milador/FAIO_Multiplexer_Wireless/Resources/Arduino_Upload.png

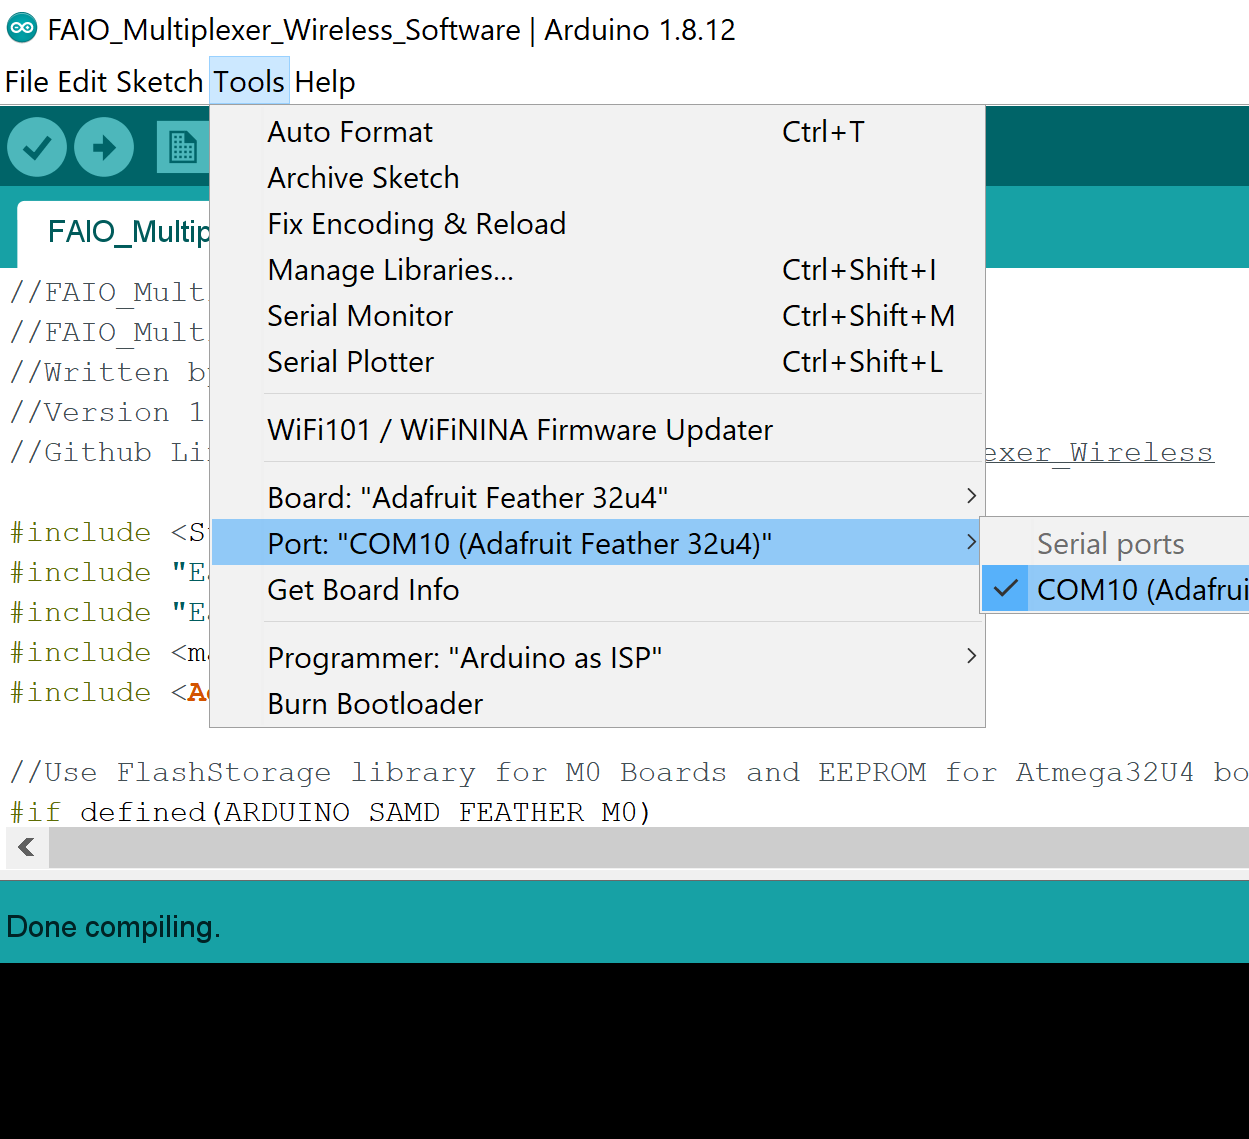
Resources/Arduino_Upload.png
