milador/FAIO_Multiplexer_Wireless/Hardware/Housing_design/STEP/FAIO_Multiplexer_Body_Battery_Holder.step

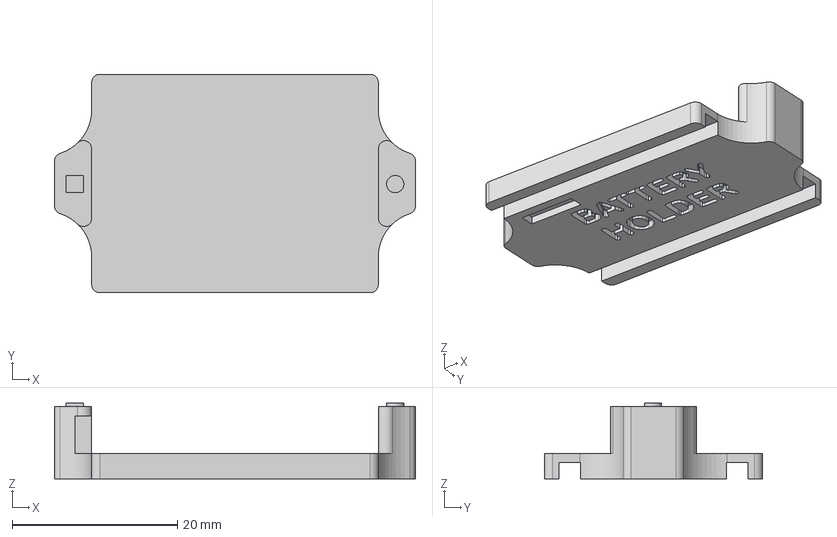
[picture p7: CAD file, 2021-01-18]
Hardware/Housing_design/STEP/FAIO_Multiplexer_Body_Battery_Holder.step
43.7 x 26.5 x 9.20 mm
