milador/FAIO_Multiplexer_Wireless/Hardware/Housing_design/STEP/FAIO_Multiplexer_Body_Bottom.step

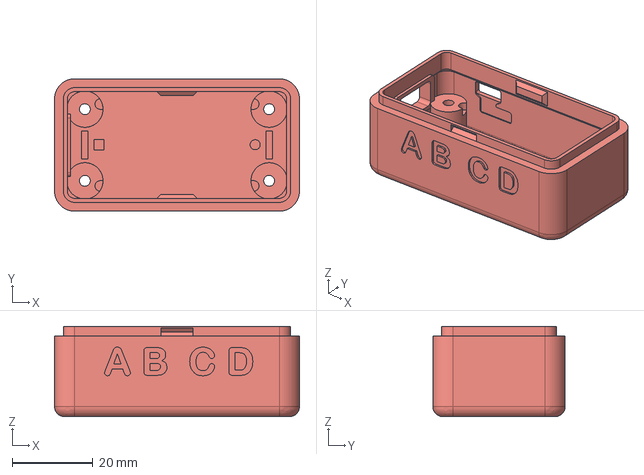
[picture p8: CAD file, 2021-01-18]
Hardware/Housing_design/STEP/FAIO_Multiplexer_Body_Bottom.step
60.8 x 32.9 x 22.4 mm
