milador/FAIO_Multiplexer_Wireless/Hardware/Housing_design/STEP/FAIO_Multiplexer_Body_Top.step

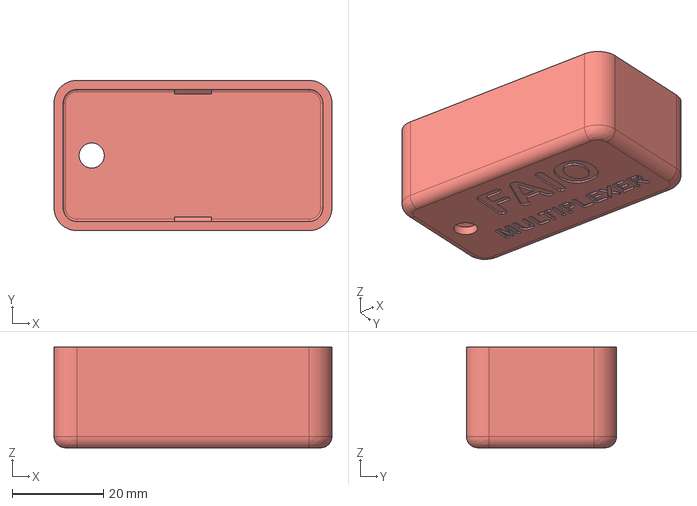
[picture p9: CAD file, 2021-01-18]
Hardware/Housing_design/STEP/FAIO_Multiplexer_Body_Top.step
60.8 x 32.9 x 22.0 mm
