milador/FAIO_Multiplexer_Wireless/(list of files, cad)

Other CAD files:
Hardware/Housing_design/STL/FAIO_Multiplexer_Body_Battery_Holder.stl
Hardware/Housing_design/STL/FAIO_Multiplexer_Body_Bottom.stl
Hardware/Housing_design/STL/FAIO_Multiplexer_Body_Bottom_With_Mount.stl
Hardware/Housing_design/STL/FAIO_Multiplexer_Body_Top.stl
