milador/FAIO_Multiplexer_Wireless/Documentation/Build_Manuals/FAIO_Multiplexer_Wireless_Instructions_Manual.pdf

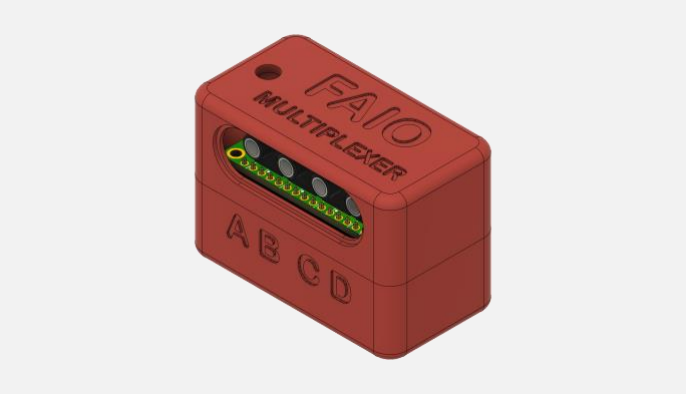
[picture p11: figure]

# FAIO MULTIPLEXER WIRELESS INSTRUCTIONS MANUAL (V1.11)

What if you could have a switch interface that would let you perform many actions using only 4 switches?

### Milad Hajihassan

https://github.com/milador/FAIO_Multiplexer_Wireless

1

## Contents

USB Version | Error! Bookmark not defined.
Board Support Packages | Error! Bookmark not defined.
Required Software and libraries | Error! Bookmark not defined.
Uploading Software | Error! Bookmark not defined.
XAC Joystick Version | Error! Bookmark not defined.
Board Support Packages | Error! Bookmark not defined.
Required Software and libraries | Error! Bookmark not defined.
Uploading Software | Error! Bookmark not defined.

2

## Components List

1. ADAFRUIT FEATHER 32U4 Bluefruit LE or ADAFRUIT FEATHER M0 Bluefruit LE x 1
2. ADDRESS LED DISC SER RGB 5MM x 1
3. FEATHER HEADER KIT FML x 1
4. RES 470 OHM 1/4W 5% AXIAL x 1
5. CONN JACK STEREO 3.5MM R/A x 4
6. HEX NUT 0.197" NYLON M2.5 x 4
7. MACH SCREW PAN SLOTTED M2.5X0.45 x 4
8. CONN HEADER VERT 5POS 2.54MM (Optional: XAC Joystick version) x 1
9. BATTERY LITHIUM 3.7V 350MAH (Optional) x 1

The FAIO_Multiplexer_Wireless_BOM or FAIO Multiplexer Wireless bill of materials can also be

downloaded from GitHub repository under main directory.

https://github.com/milador/FAIO_Multiplexer_Wireless/blob/master/Components/FAIO_Multiplexer_

Wireless_BOM.xlsx (https://github.com/milador/FAIO_Multiplexer_Wireless/blob/master/Components/FAIO_Multiplexer_Wireless_BOM.xlsx)

3

## Software

The FAIO Multiplexer Wireless software can be downloaded from the GitHub repository under software directory.

The FAIO Multiplexer Wireless hardware can be used along different software as input device for multiple devices. The FAIO Multiplexer Wireless software is offered in the following flavors:

Wireless Version: FAIO_Multiplexer_Wireless_Software (https://github.com/milador/FAIO_Multiplexer_Wireless/tree/master/Software/FAIO_Multiplexer_Wireless_Software)

### Installing Arduino Libraries

The following instructions on how to install additional Arduino libraries helps you to get started with setting up Arduino IDE with required libraries and dependencies.

https://www.arduino.cc/en/guide/libraries

### Wireless Version

Board Support Packages
You can find the official instructions to install Board Support Packages on Adafruit website using following links:

https://learn.adafruit.com/adafruit-feather-m0-bluefruit-le/setup

https://learn.adafruit.com/adafruit-feather-32u4-bluefruit-le//setup

Note: Please follow the instructions depending on your Adafruit Feather board model.

The wireless version of the FAIO Multiplexer Wireless is using nRF51 Bluetooth chip to communicate with host devices. Bluetooth communication might seem complicated but Adafruit has made the bluetooth communication process less challenging by providing Adafruit nRF51 BLE Library which you can download from Adafruit and import it to your locally installed Arduino directory under libraries directory.

https://github.com/adafruit/Adafruit_BluefruitLE_nRF51

The instructions on how to install Adafruit nRF51 BLE Library can be found in following link:

https://learn.adafruit.com/adafruit-feather-32u4-bluefruit-le/installing-ble-library

Alternatively, you can perform following instructions to install Board Support Packages:

### 1. Open and start the Arduino IDE 2. Go to File > Preferences 3. Add following link as a new line under Additional Board Manager URLs

- https://www.adafruit.com/package_adafruit_index.json

### 4. Restart the Arduino IDE 5. Open the Boards Manager option from the Tools > Board menu and install Adafruit SAMD

Boards by Adafruit or Adafruit SAMD Boards by Adafruit depending on your board.
6. Wait until the IDE finishes installing the cross-compiling toolchain and tools associated with Board Support Package. This may take few minutes.

4

7. That’s it! The installation of Board Support Packages is finished.

Required Software and libraries
The wireless version of the software requires the following files and libraries:
- StopWatch library (https://github.com/RobTillaart/Stopwatch_RT)
- EasyMorseBlue library (https://github.com/milador/EasyMorseBlue)
- Adafruit_NeoPixel library (https://github.com/adafruit/Adafruit_NeoPixel)
- FlashStorage library (https://github.com/cmaglie/FlashStorage) (Optional: Only Feather M0 Board)
- Bluefruit Arduino Library (https://learn.adafruit.com/adafruit-feather-32u4-bluefruit-le/installing-ble-library)
- FAIO_Multiplexer_Wireless_Software.ino (https://github.com/milador/FAIO_Multiplexer_Wireless/blob/master/Software/FAIO_Multiplexer_Wireless_Software/FAIO_Multiplexer_Wireless_Software.inoare.ino)

StopWatch library helps to calculate the reaction time and timeout in the morse code interface.

The EasyMorseBlue library is the Bluetooth version of EasyMorse library which is used to enable the end user to use morse code or a sequence of dots and dashes as input method.

FAIO Multiplexer Wireless is using Adafruit_NeoPixel library to provide visual feedback using RGB LED.

1. Visit the StopWatch library (https://github.com/RobTillaart/Stopwatch_RT) github repository page.
2. Click on Code > Download Zip to download StopWatch library.

### 3. Extract Stopwatch_RT-master.zip file 4. Rename Stopwatch_RT-master folder to Stopwatch folder under Stopwatch_RT-master

subdirectory.
5. Copy or move Stopwatch folder to Arduino installation library subdirectory. As an example: This is found under C:\Program Files (x86)\Arduino\libraries in windows 10.
6. Visit the EasyMorseBlue library (https://github.com/milador/EasyMorseBlue) github repository page.
7. Click on Code > Download Zip to download EasyMorseBlue library.

### 8. Extract EasyMorse.zip file 9. Rename EasyMorseBlue-master folder to EasyMorseBlue folder under EasyMorseBlue-master

subdirectory.
10. Copy or move EasyMorseBlue folder to Arduino installation library subdirectory. As an example: This is found under C:\Program Files (x86)\Arduino\libraries in windows 10.
11. Visit the FlashStorage library (https://github.com/cmaglie/FlashStorage) github repository page.
12. Click on Code > Download Zip to download FlashStorage library.

### 13. Extract FlashStorage.zip file 14. Rename FlashStorage-master folder to FlashStorage folder under FlashStorage -master

subdirectory.
15. Copy or move FlashStorage folder to Arduino installation library subdirectory. As an example: This is found under C:\Program Files (x86)\Arduino\libraries in windows 10.

### 16. Click on Sketch > Include Library > Manage Libraries…

17. Search for the Adafruit BluefruitLE nRF51 library and install it.
18. Visit the FAIO_Multiplexer_Wireless_Software.ino (https://github.com/milador/FAIO_Multiplexer_Wireless/blob/master/Software/FAIO_Multiplexer_Wireless_Software/FAIO_Multiplexer_Wireless_Software.inoare.ino) raw source code file under FAIO_Multiplexer_Wireless github repository page.

### 19. Right click on the source code or any place on this page and select Save Page As…

20. Select the directory you would like to save the software in your computer.

5

### 21. Change File name from FAIO_Multiplexer_Wireless_Software to

FAIO_Multiplexer_Wireless_Software.ino
22. Change Save as type to All Files.
23. Click on Save button.
24. Open the directory you selected in step 20.

### 25. Double left click or open FAIO_Multiplexer_Wireless_Software file 26. Arduino IDE will ask your permission to create a new sketch folder named

FAIO_Multiplexer_Wireless_Software and move FAIO_Multiplexer_Wireless_Software.ino under this folder.
27. Click on the Ok button.
28. Arduino IDE should now open the FAIO_Multiplexer_Wireless_Software.ino file automatically.

Uploading Software
Note: Make sure all three files are included in your local copy of Software directory before uploading it to the Adafruit Feather board. The libraries can be installed in Arduino libraries.

You can go ahead and upload the downloaded. ino software to Adafruit Feather board using Arduino IDE once all the necessary libraries are installed.

1. Select the Board under Tools > Board > Adafruit Boards as Adafruit Feather 32u4 or under Tools > Board > Adafruit SAMD Boards as Adafruit Feather M0 based on your board.
2. Select the correct port number under Tools > Port which should say COM XX (Adafruit Feather 32u4) or COM XX (Adafruit Feather M0) based on your board

Note: It’s very important to make sure the correct Board and port number are selected as selecting the wrong board may result problems with bootloader of Adafruit Feather board.

1. Press the Verify button to make sure there is no problem with the software and libraries.

### 2. Press Upload button

You can now go ahead and upload the software. Arduino IDE will show you a Done Uploading message indicating the software is uploaded to your FAIO Multiplexer Wireless.

The LED on the FAIO Multiplexer Wireless main board blinks two times in teal to indicate the start of initialization process has been started and it will blink again two times in green to indicate end of the initialization process.

You can also open the Serial Monitor in Arduino IDE on 115200 baud-rate to read initialization information about the version of software.

6

## Hardware Assembly

### Printed circuit Board design

The printed circuit boards (PCB) can be downloaded from GitHub repository under Hardware directory.

https://github.com/milador/FAIO_Multiplexer_Wireless/tree/master/Hardware/PCB_design

### Enclosure design

The enclosure/housing files in STL format can be downloaded from GitHub repository under Hardware directory.

https://github.com/milador/FAIO_Multiplexer_Wireless/tree/master/Hardware/Housing_design

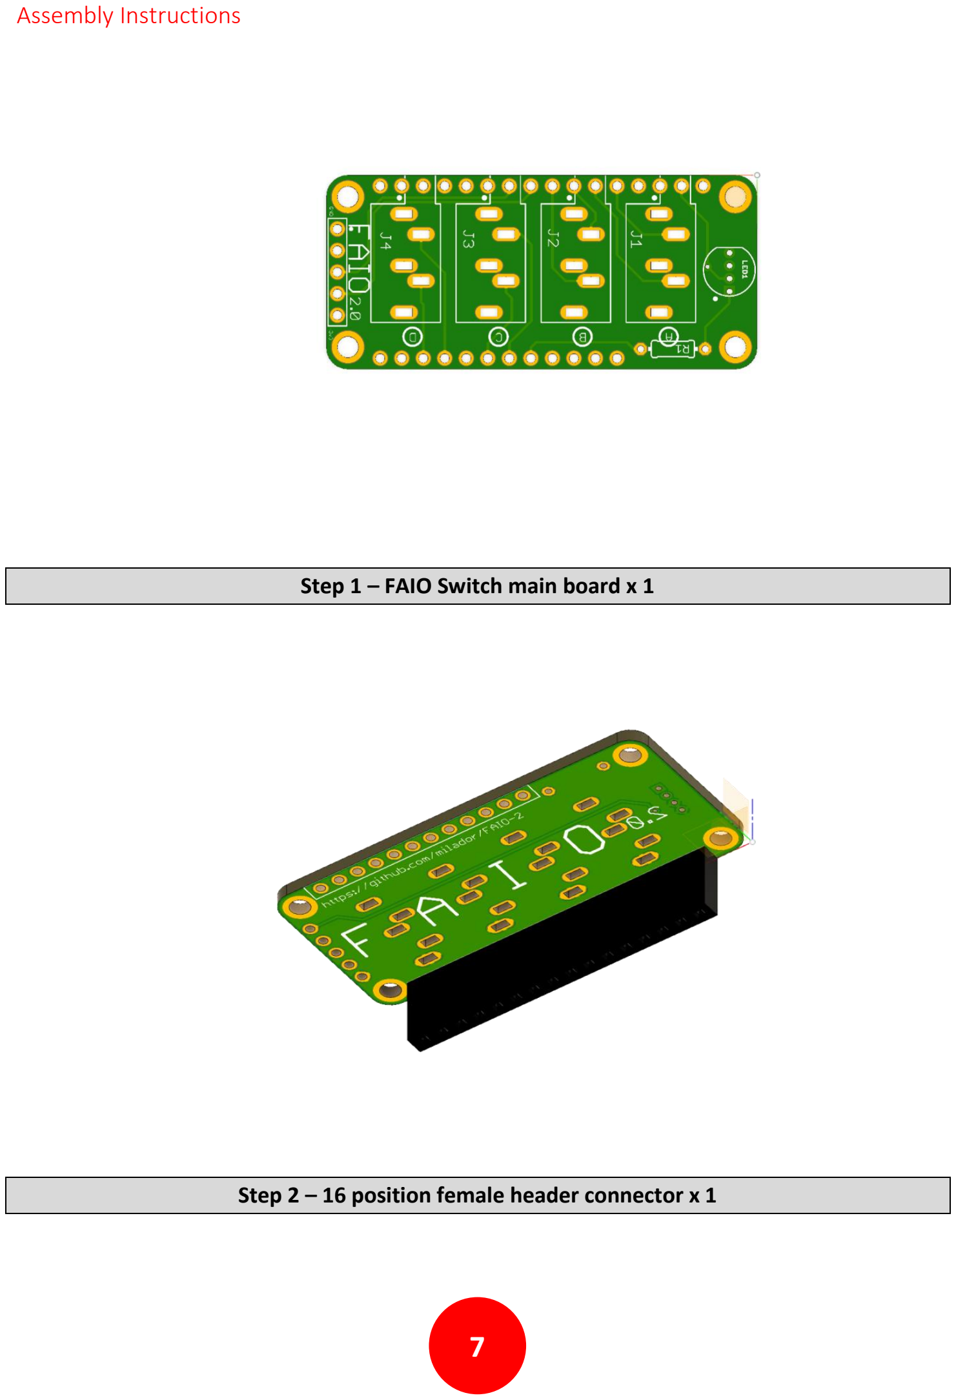
[picture p12: page 8]

7

### Assembly Instructions

Step 1 – FAIO Switch main board x 1
Step 2 – 16 position female header connector x 1

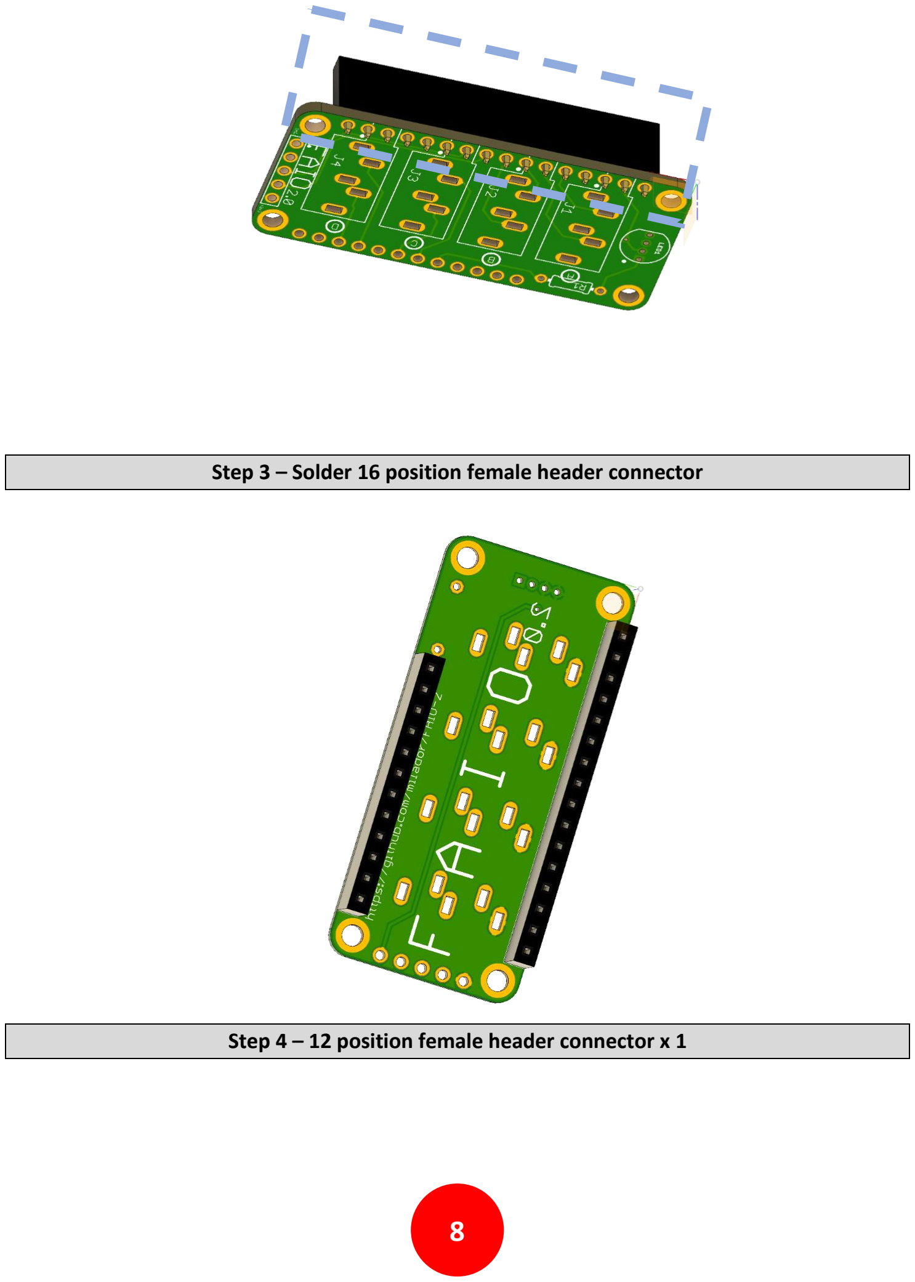
[picture p13: page 9]

8

Step 3 – Solder 16 position female header connector
Step 4 – 12 position female header connector x 1

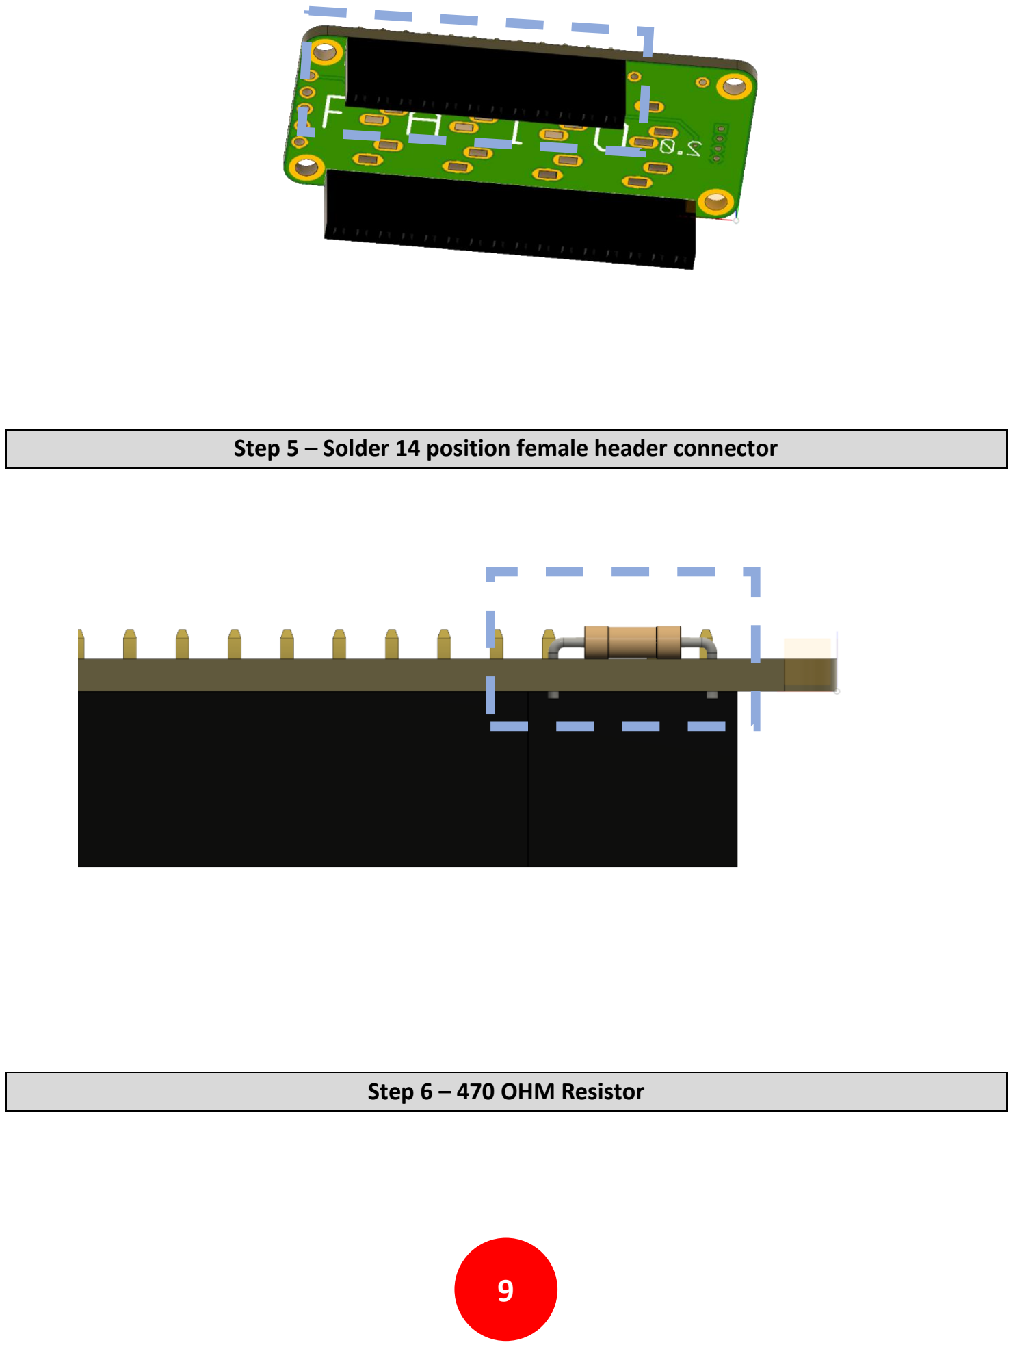
[picture p14: page 10]

9

Step 5 – Solder 14 position female header connector
Step 6 – 470 OHM Resistor

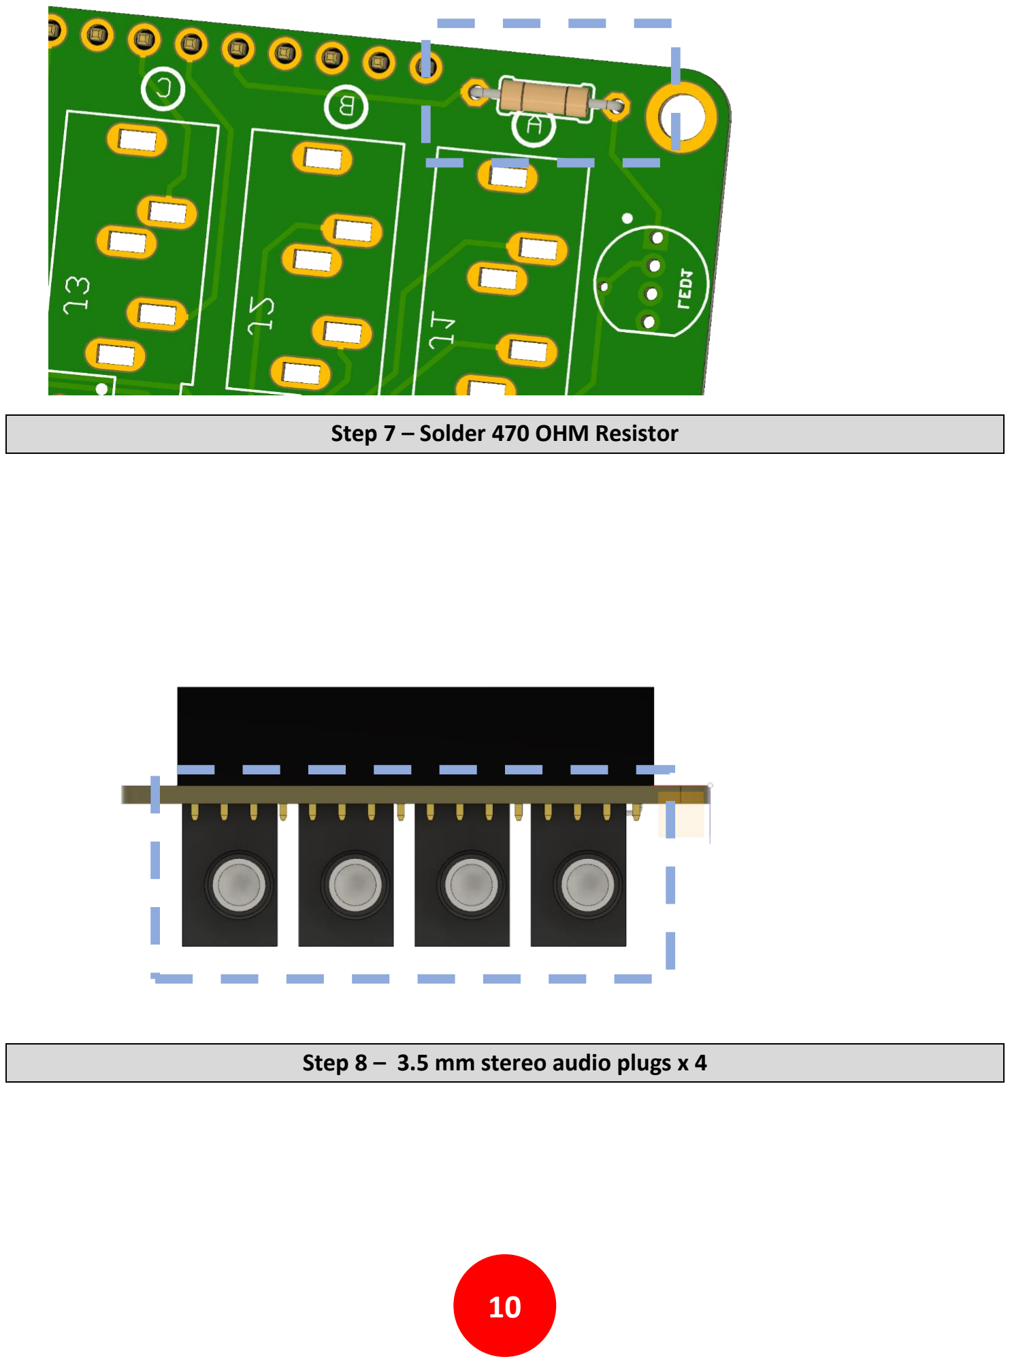
[picture p15: page 11]

10

Step 7 – Solder 470 OHM Resistor
Step 8 – 3.5 mm stereo audio plugs x 4

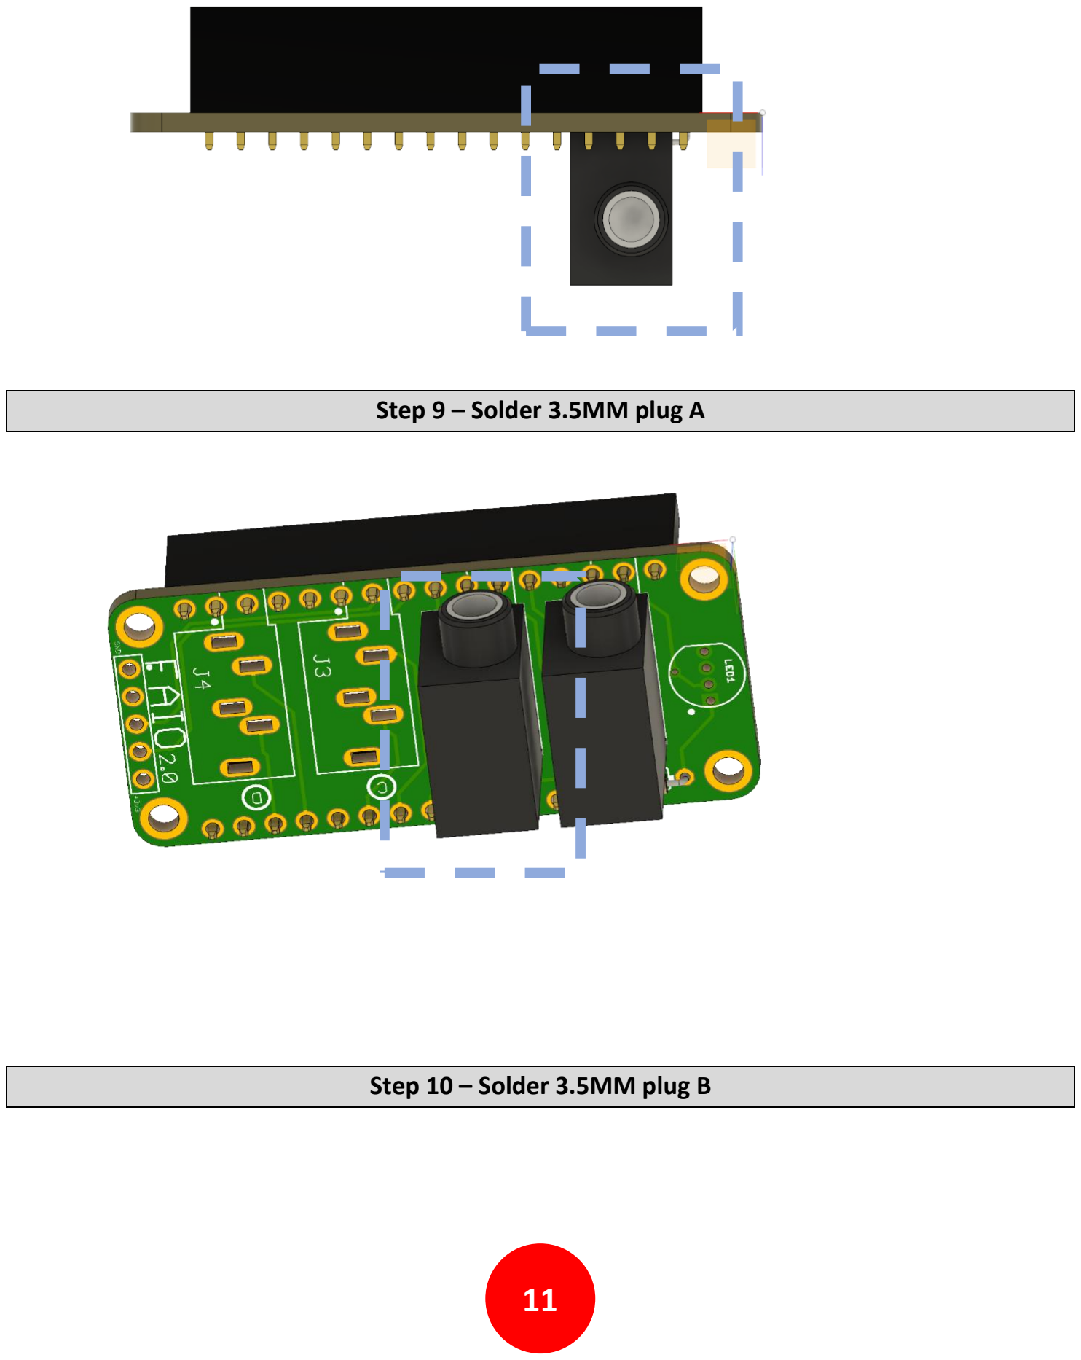
[picture p16: page 12]

11

Step 9 – Solder 3.5MM plug A
Step 10 – Solder 3.5MM plug B

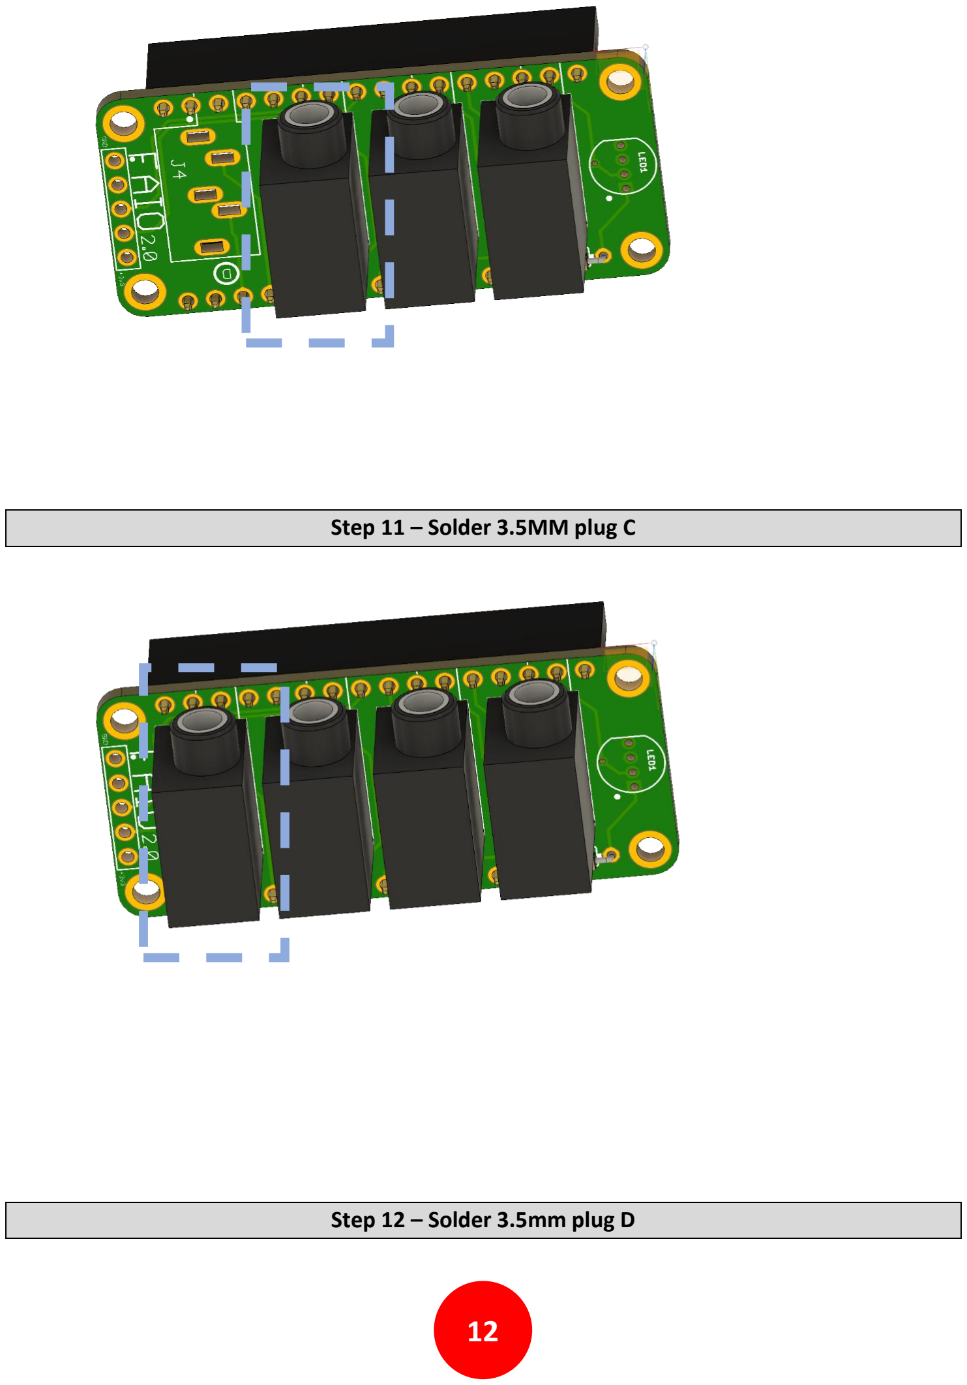
[picture p17: page 13]

12

Step 11 – Solder 3.5MM plug C
Step 12 – Solder 3.5mm plug D

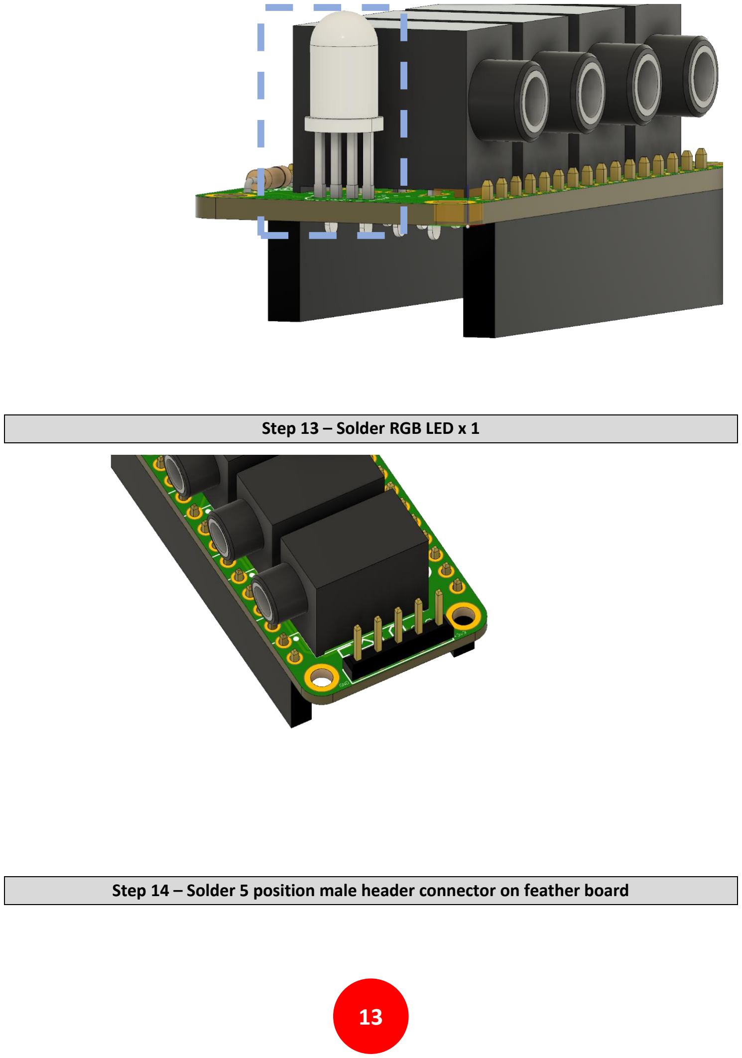
[picture p18: page 14]

13

Step 13 – Solder RGB LED x 1
Step 14 – Solder 5 position male header connector on feather board

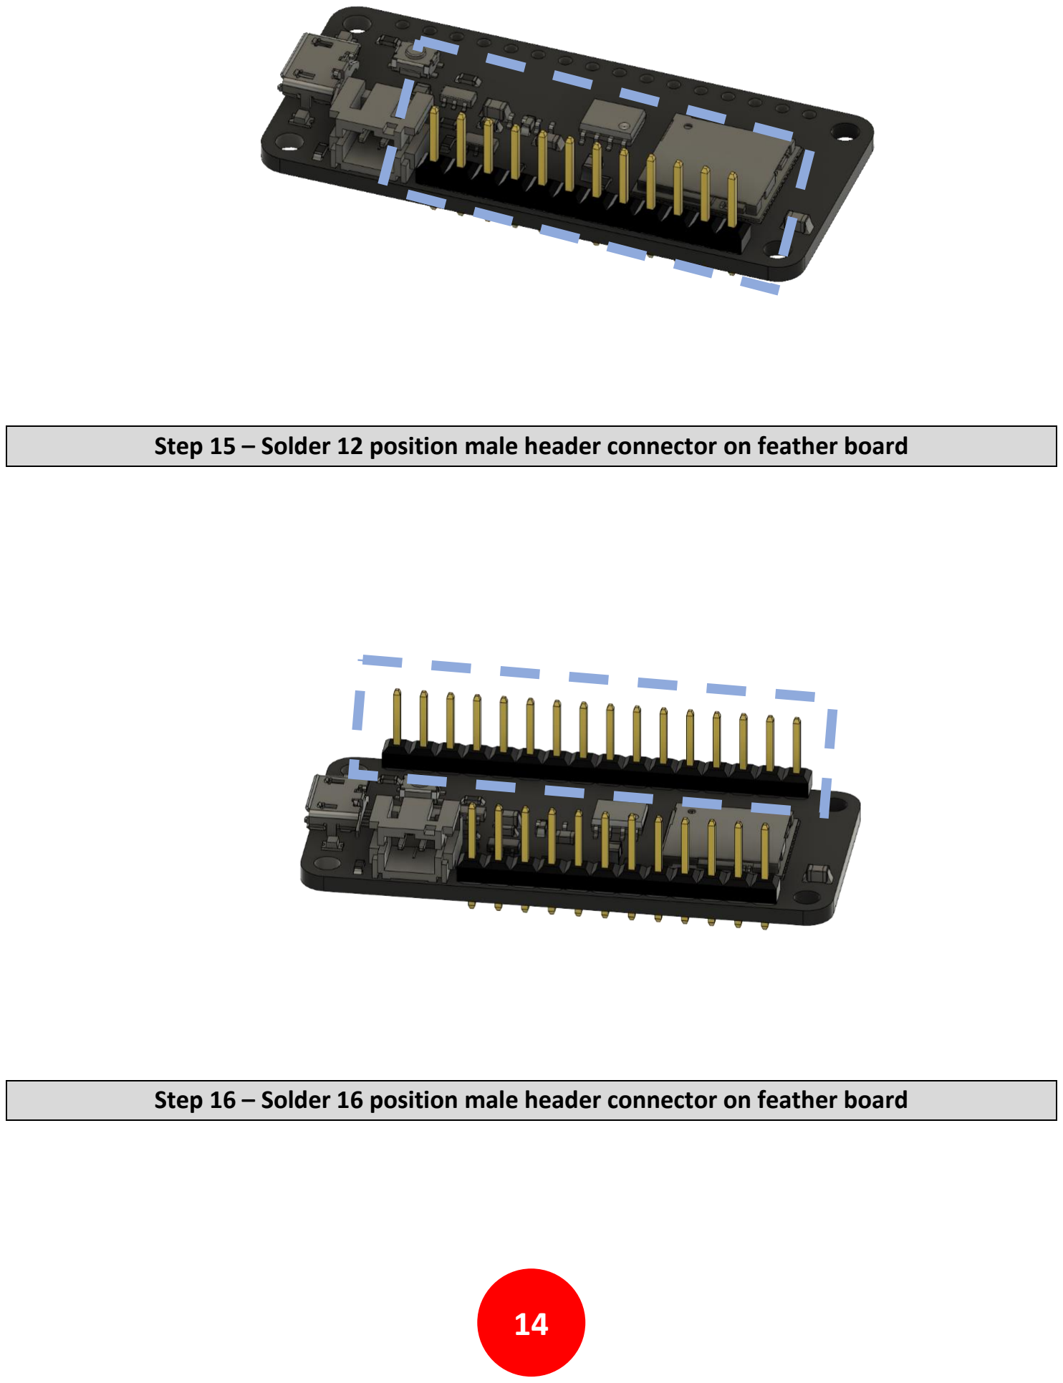
[picture p19: page 15]

14

Step 15 – Solder 12 position male header connector on feather board
Step 16 – Solder 16 position male header connector on feather board

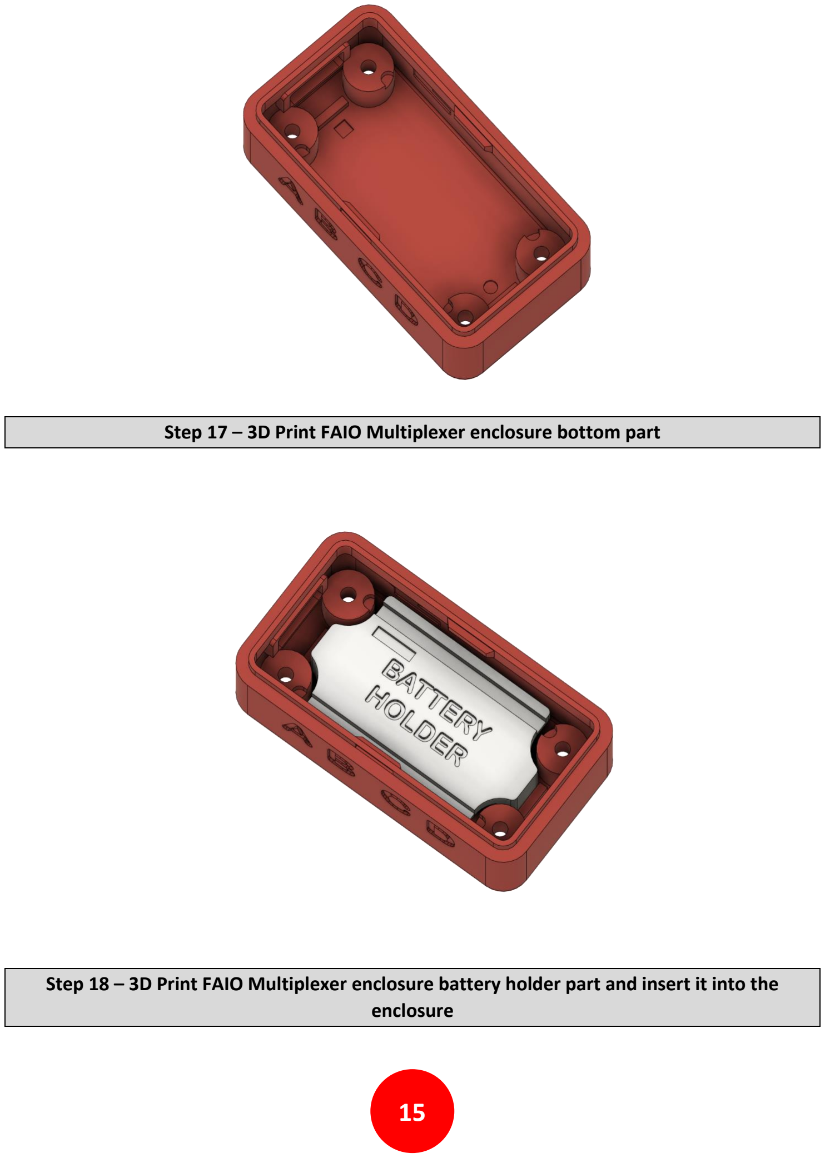
[picture p20: page 16]

15

Step 17 – 3D Print FAIO Multiplexer enclosure bottom part
Step 18 – 3D Print FAIO Multiplexer enclosure battery holder part and insert it into the enclosure

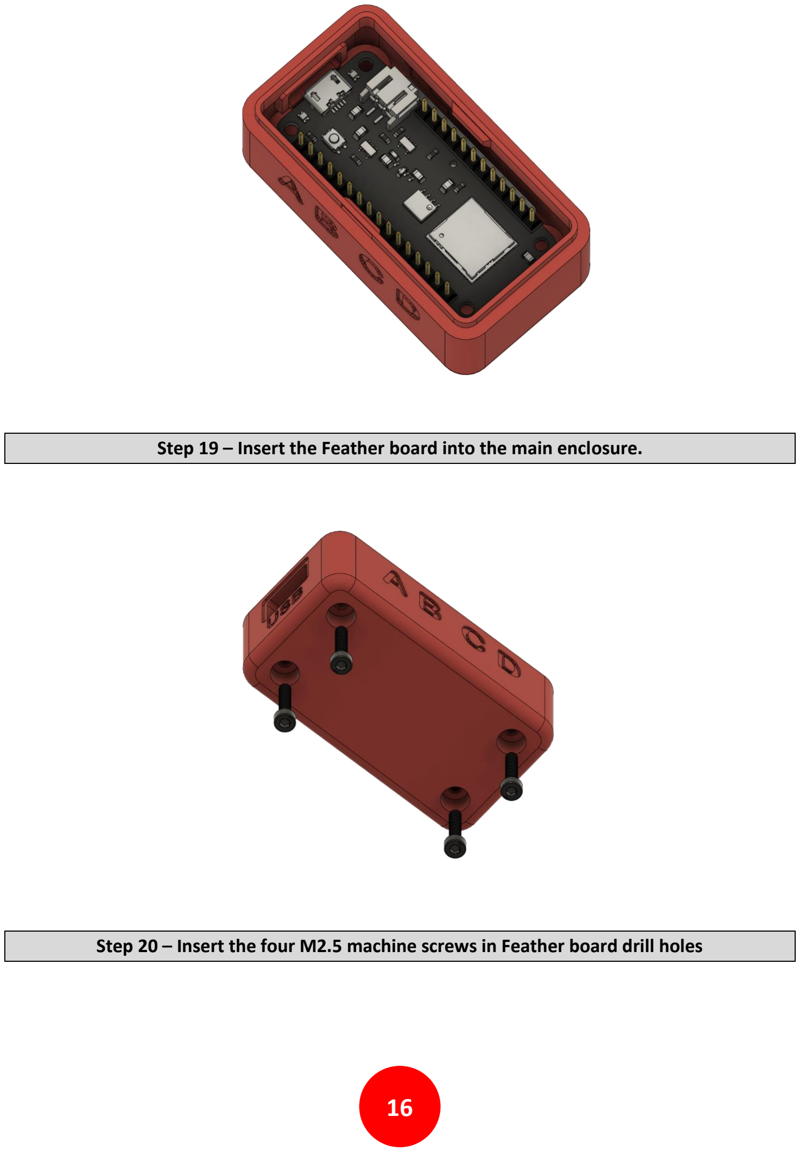
[picture p21: page 17]

16

Step 19 – Insert the Feather board into the main enclosure.
Step 20 – Insert the four M2.5 machine screws in Feather board drill holes

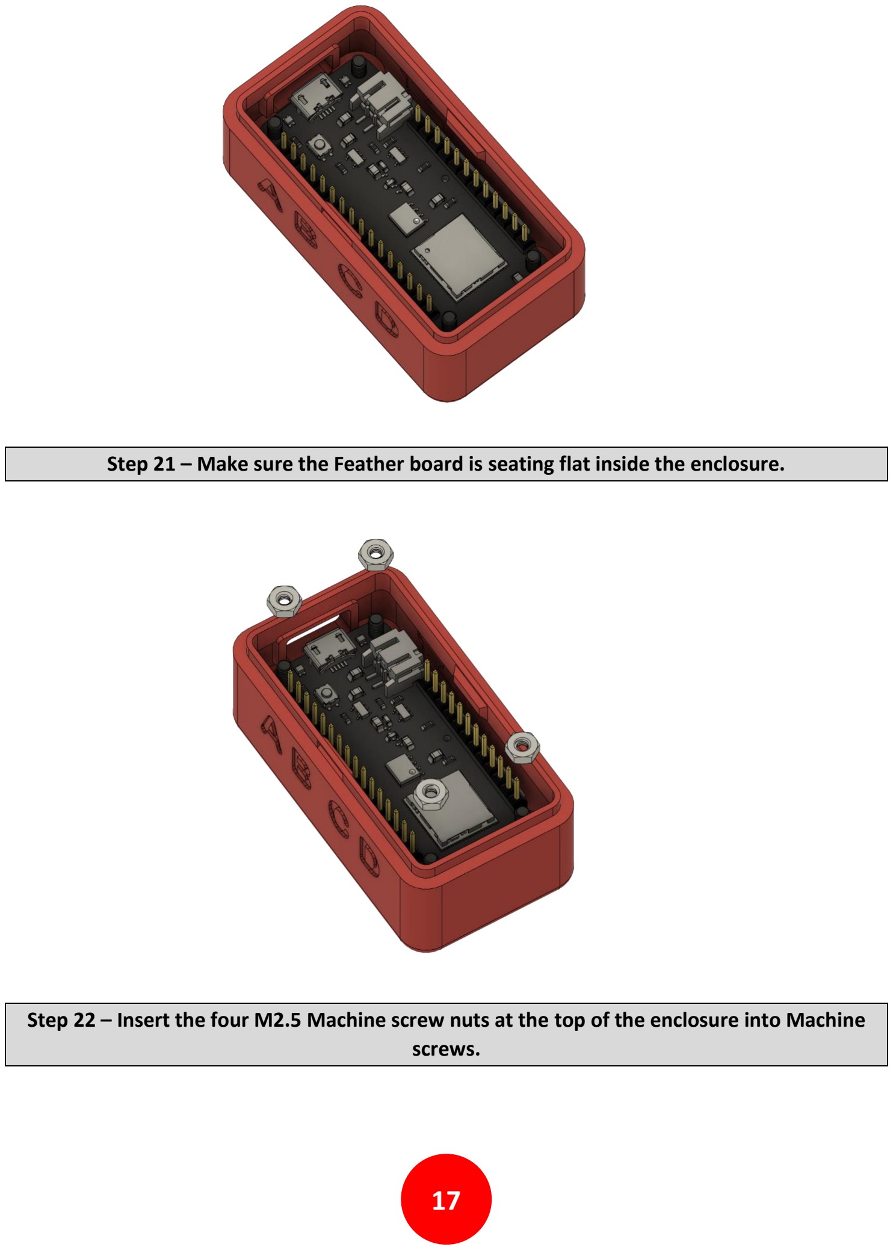
[picture p22: page 18]

17

Step 21 – Make sure the Feather board is seating flat inside the enclosure.
Step 22 – Insert the four M2.5 Machine screw nuts at the top of the enclosure into Machine screws.

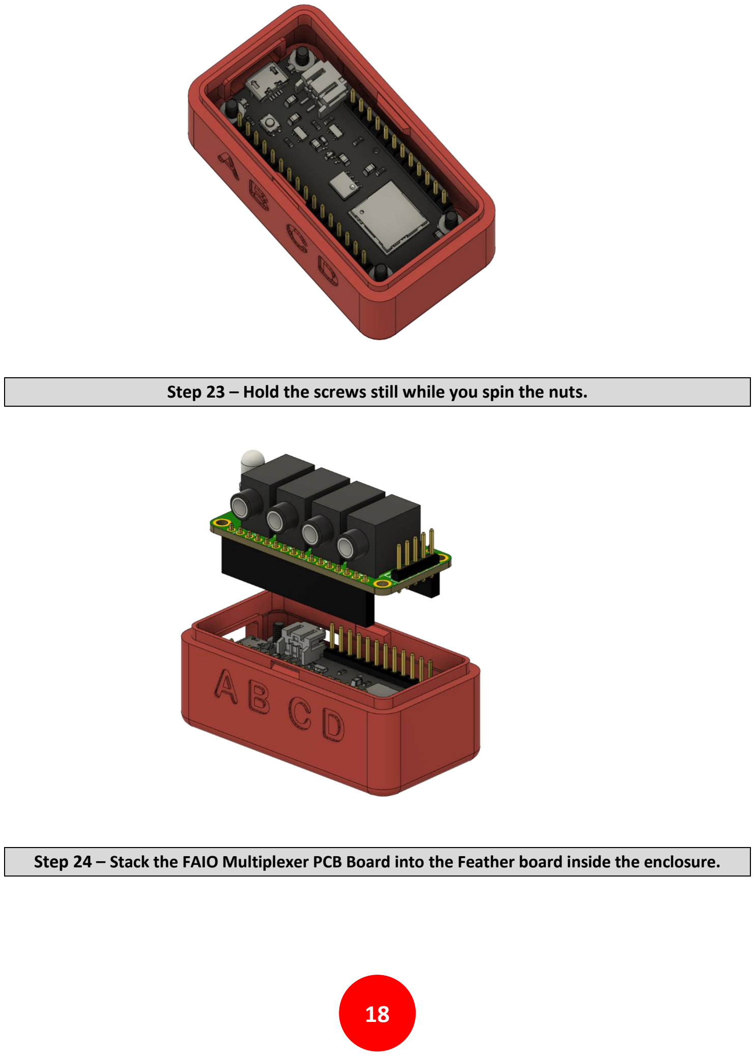
[picture p23: page 19]

18

Step 23 – Hold the screws still while you spin the nuts.
Step 24 – Stack the FAIO Multiplexer PCB Board into the Feather board inside the enclosure.

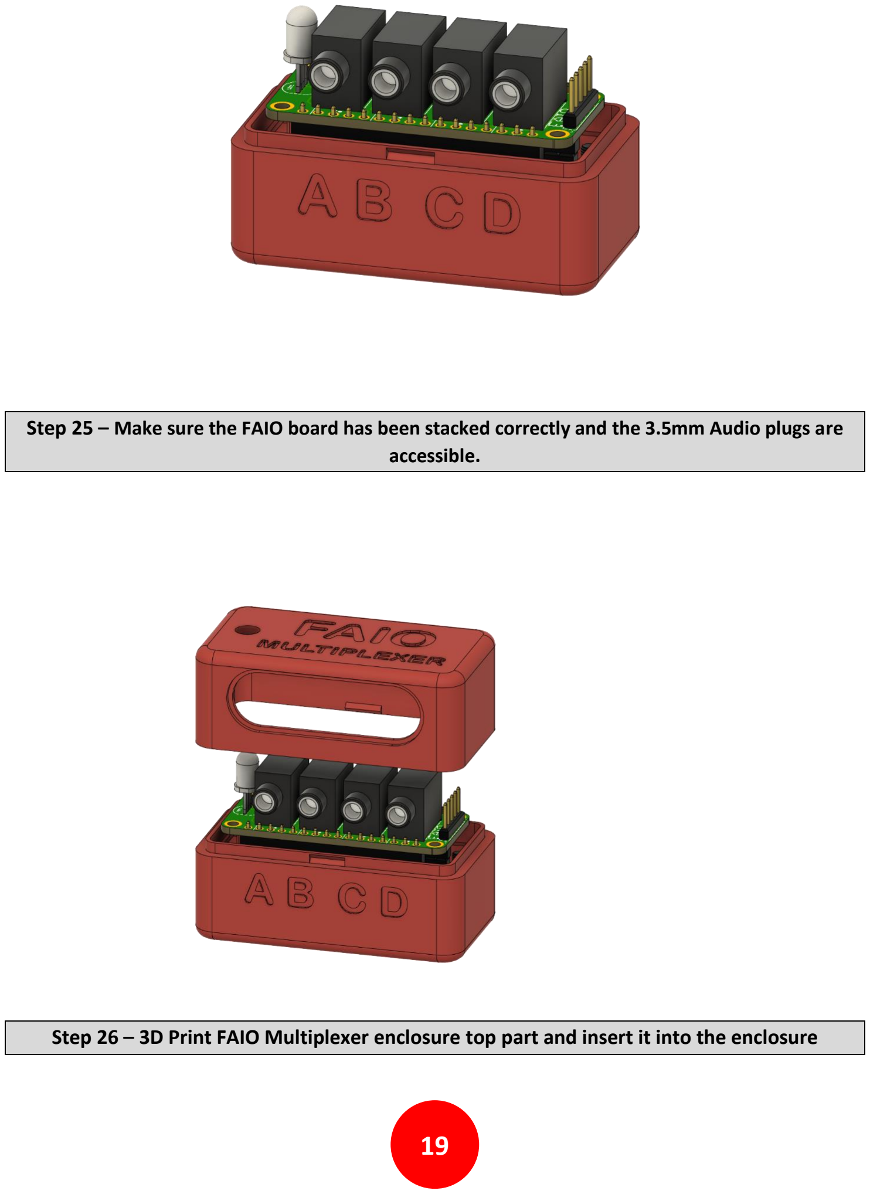
[picture p24: page 20]

19

Step 25 – Make sure the FAIO board has been stacked correctly and the 3.5mm Audio plugs are accessible.
Step 26 – 3D Print FAIO Multiplexer enclosure top part and insert it into the enclosure

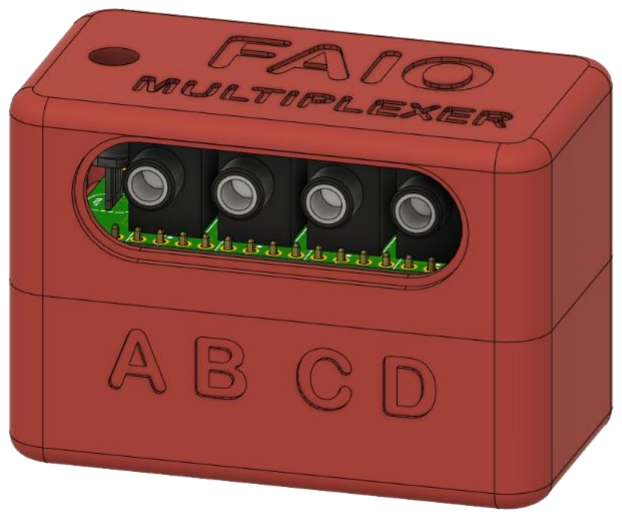
[picture p25: figure]

20

Step 27 – That’s it! Your FAIO Multiplexer is fully assembled and ready to use.
