milador/FAIO_Multiplexer_Wireless/Hardware/PCB_design/FAIO_Multiplexer.brd

## EAGLE design Hardware/PCB_design/FAIO_Multiplexer.brd (2021-03-14)

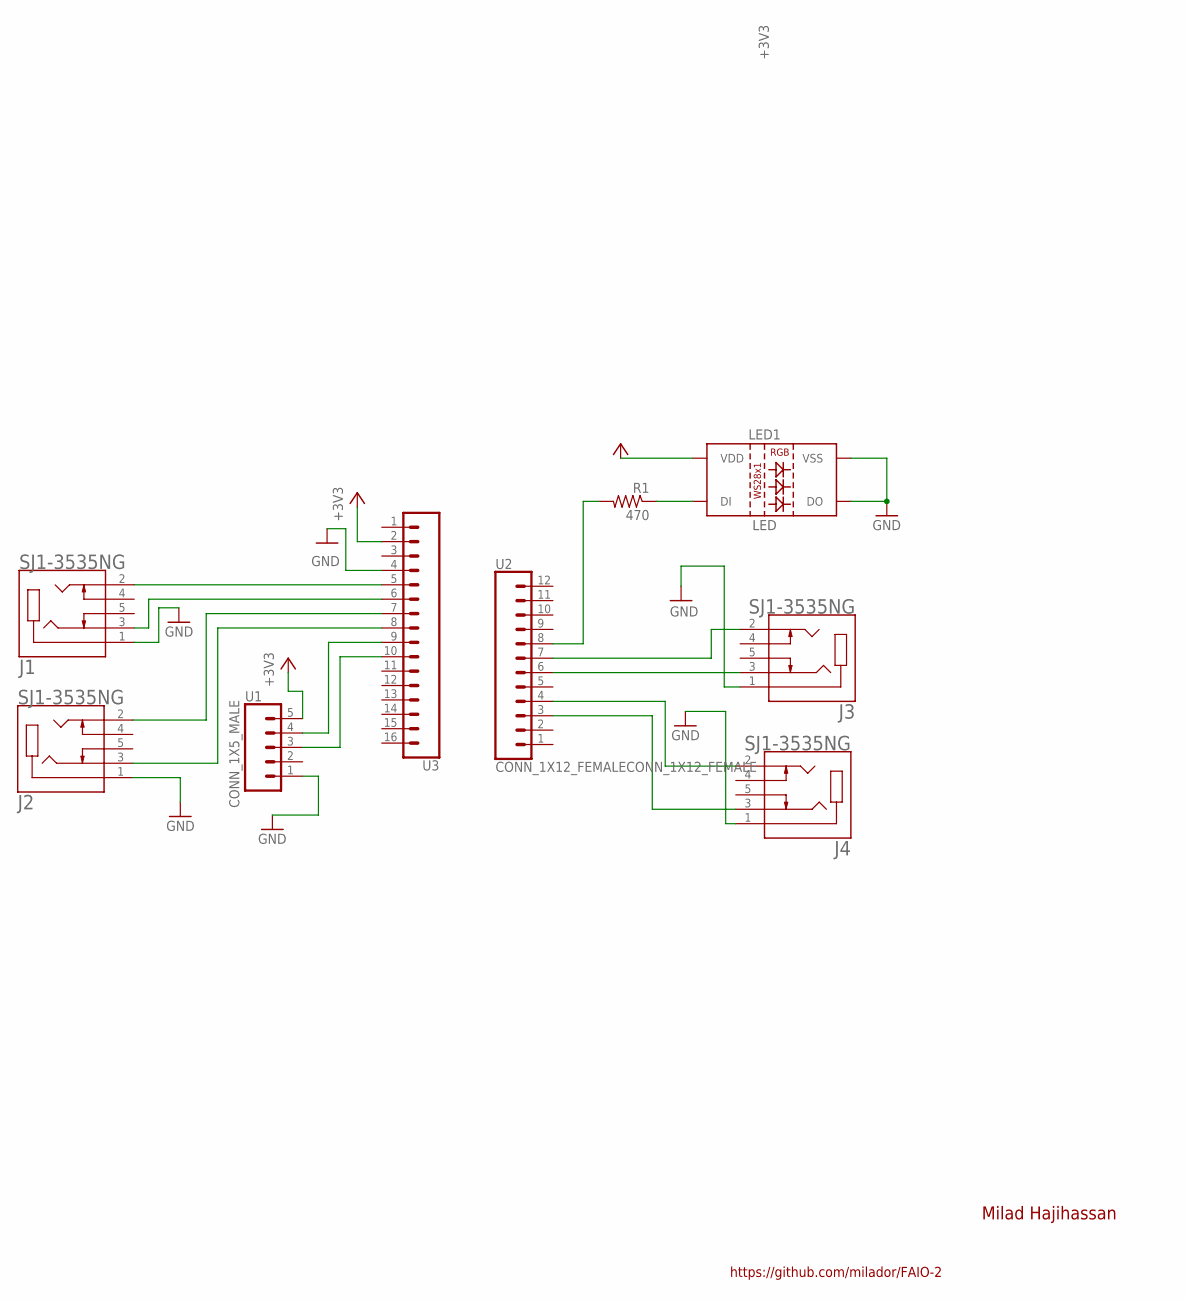
[picture p27: schematic FAIO_Multiplexer.sch]

Parts:
J1, J2, J3, J4: SJ1-3535NG; CUI_SJ1-3535NG
LED1: LED; NEOPIXELS-5MM
R1: 470; 0204/7
U1: CONN_1X5_MALE; CONN_1X5
U2: CONN_1X12_FEMALECONN_1X12_FEMALE; CONN_1X12
U3: CONN_1X16_FEMALECONN_1X16_FEMALE; CONN_1X16

Connections:
+3V3: LED1.2 (VDD), U1.5, U3.2
GND: J1.1, J2.1, J3.1, J4.1, LED1.3 (VSS), LED1.4 (DO), U1.1, U3.4
unnamed: J3.3, U2.6
unnamed: J3.2, U2.7
unnamed: J4.2, U2.4
unnamed: LED1.1 (DI), R1.1
unnamed: J4.3, U2.3
unnamed: R1.2, U2.8
unnamed: U1.4, U3.9
unnamed: J1.2, U3.5
unnamed: J1.3, U3.6
unnamed: J2.2, U3.7
unnamed: U1.3, U3.10
unnamed: J2.3, U3.8

Notes on the sheet:
https://github.com/milador/FAIO-2
Milad Hajihassan

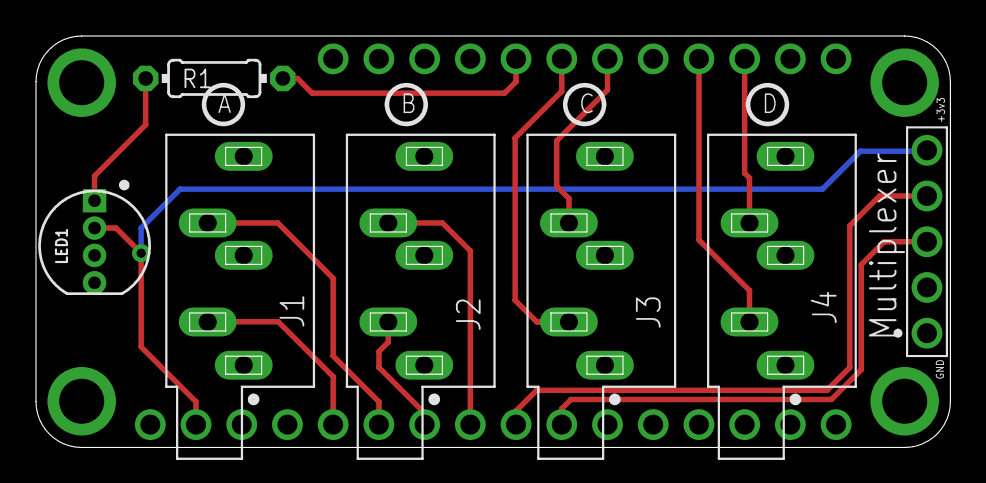
[picture p28: board FAIO_Multiplexer.brd from above]

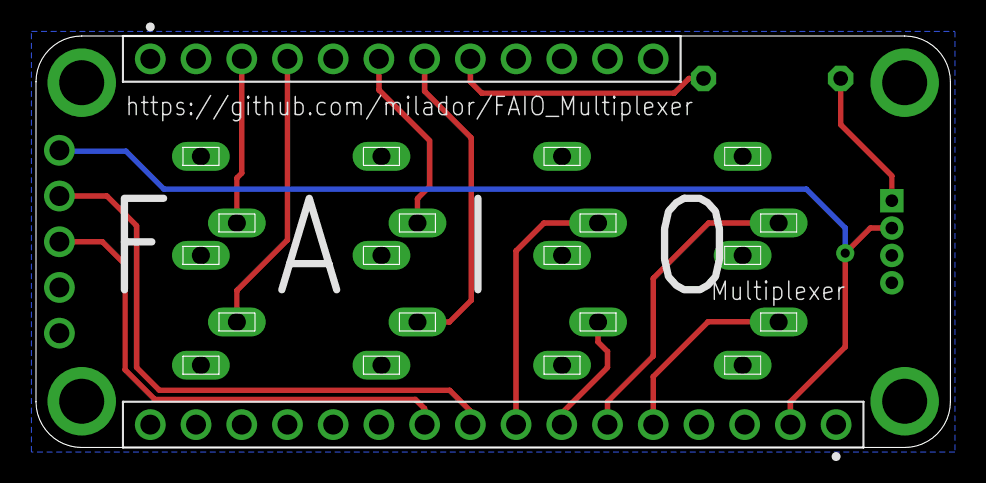
[picture p29: board FAIO_Multiplexer.brd from below]

Board: 2 copper layers, 50.8 x 22.9 mm, 9 parts (2 on the bottom side), 14 nets.
