milador/FAIO_Multiplexer_Wireless/(commit log)

2020-07-24 Added Initial files
    [FAIO-Joystick-Bottom-Box.stl, FAIO-Joystick-Handle.stl, FAIO-Joystick-Top-Box.stl, FAIO_Multiplexer.brd, FAIO_Multiplexer.sch, FAIO_Multiplexer_Body_Battery_Holder.stl, FAIO_Multiplexer_Body_Bottom.stl, FAIO_Multiplexer_Body_Top.stl]
2020-12-20 Updated BOM and added M2.5 screws
    [FAIO_Multiplexer_Wireless_BOM.csv, FAIO_Multiplexer_Wireless_BOM.xlsx]
2021-01-11 Updated BOM file for the new enclosure
    [FAIO_Multiplexer_Wireless_BOM.csv, FAIO_Multiplexer_Wireless_BOM.xlsx]
2021-01-11 Updated enclosure design with new snap fit design
    [FAIO-Joystick-Bottom-Box.stl, FAIO-Joystick-Handle.stl, FAIO-Joystick-Top-Box.stl, FAIO_Multiplexer_Body_Battery_Holder.step, FAIO_Multiplexer_Body_Battery_Holder.stl, FAIO_Multiplexer_Body_Bottom.step, FAIO_Multiplexer_Body_Bottom.stl, FAIO_Multiplexer_Body_Bottom_Mount.step]
2021-01-11 Update Manuals for the new enclosure
2021-01-12 Updated enclosure STL files (2.7mm holder holes)
    [FAIO_Multiplexer_Body_Battery_Holder.step, FAIO_Multiplexer_Body_Battery_Holder.stl, FAIO_Multiplexer_Body_Bottom.step, FAIO_Multiplexer_Body_Bottom.stl, FAIO_Multiplexer_Body_Bottom_Mount.step, FAIO_Multiplexer_Body_Bottom_Mount.stl, FAIO_Multiplexer_Body_Top.step, FAIO_Multiplexer_Body_Top.stl]
2021-01-12 Updated enclosure file links
2021-01-18 Updated enclosure files : New snap fit design
    [FAIO_Multiplexer_Body_Battery_Holder.step, FAIO_Multiplexer_Body_Battery_Holder.stl, FAIO_Multiplexer_Body_Bottom.step, FAIO_Multiplexer_Body_Bottom.stl, FAIO_Multiplexer_Body_Bottom_Mount.step, FAIO_Multiplexer_Body_Bottom_Mount.stl, FAIO_Multiplexer_Body_Bottom_With_Mount.step, FAIO_Multiplexer_Body_Bottom_With_Mount.stl]
2021-01-18 Updated instructions and user manuals : Updated images of enclosure.
2021-01-18 Added PCB gerber files
2021-01-31 Updated Assembly manual 1.11
2021-03-14 Update silkscreen
    [FAIO_Multiplexer.brd, FAIO_Multiplexer.sch]
